Rayner70/Hand-Gesture-Controlled-4-DOF-Robotic-Arm/diagrams/Arm_circuit_diagram.png

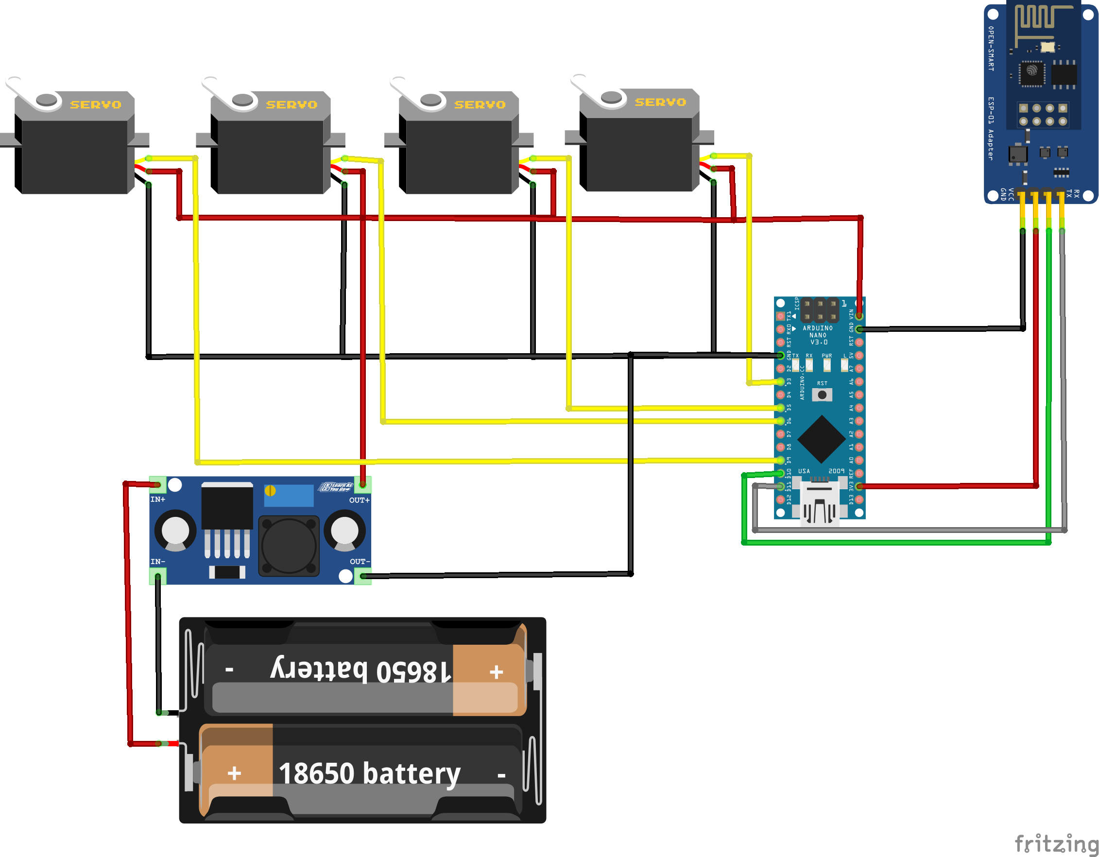
diagrams/Arm_circuit_diagram.png
