Rayner70/Hand-Gesture-Controlled-4-DOF-Robotic-Arm/diagrams/Glove_Circuit_Diagram.png

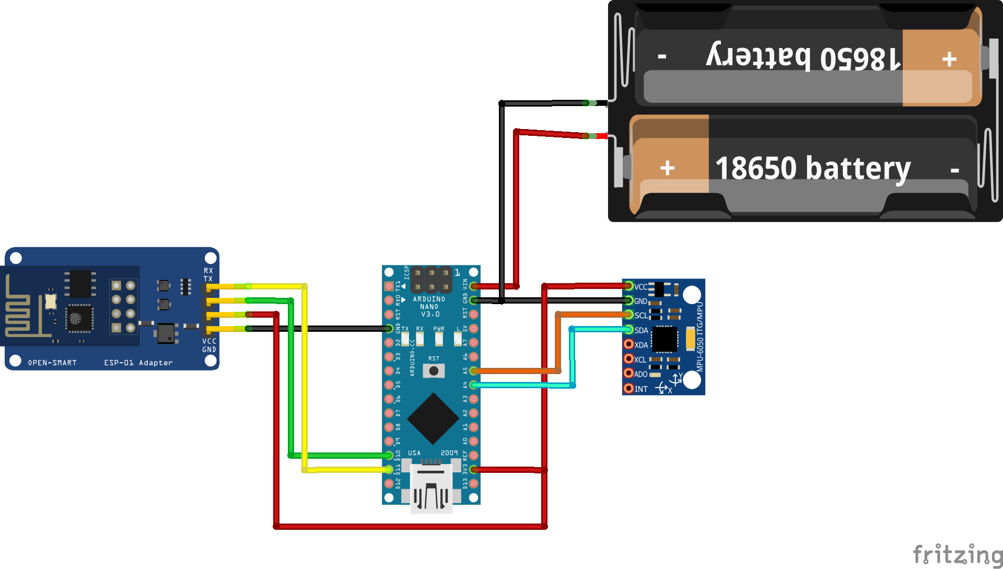
diagrams/Glove_Circuit_Diagram.png
